kylemanna/teensy-toslink-receiver/teensy-toslink-receiver.kicad_pcb

## KiCad design teensy-toslink-receiver.kicad_pcb (2020-12-26)

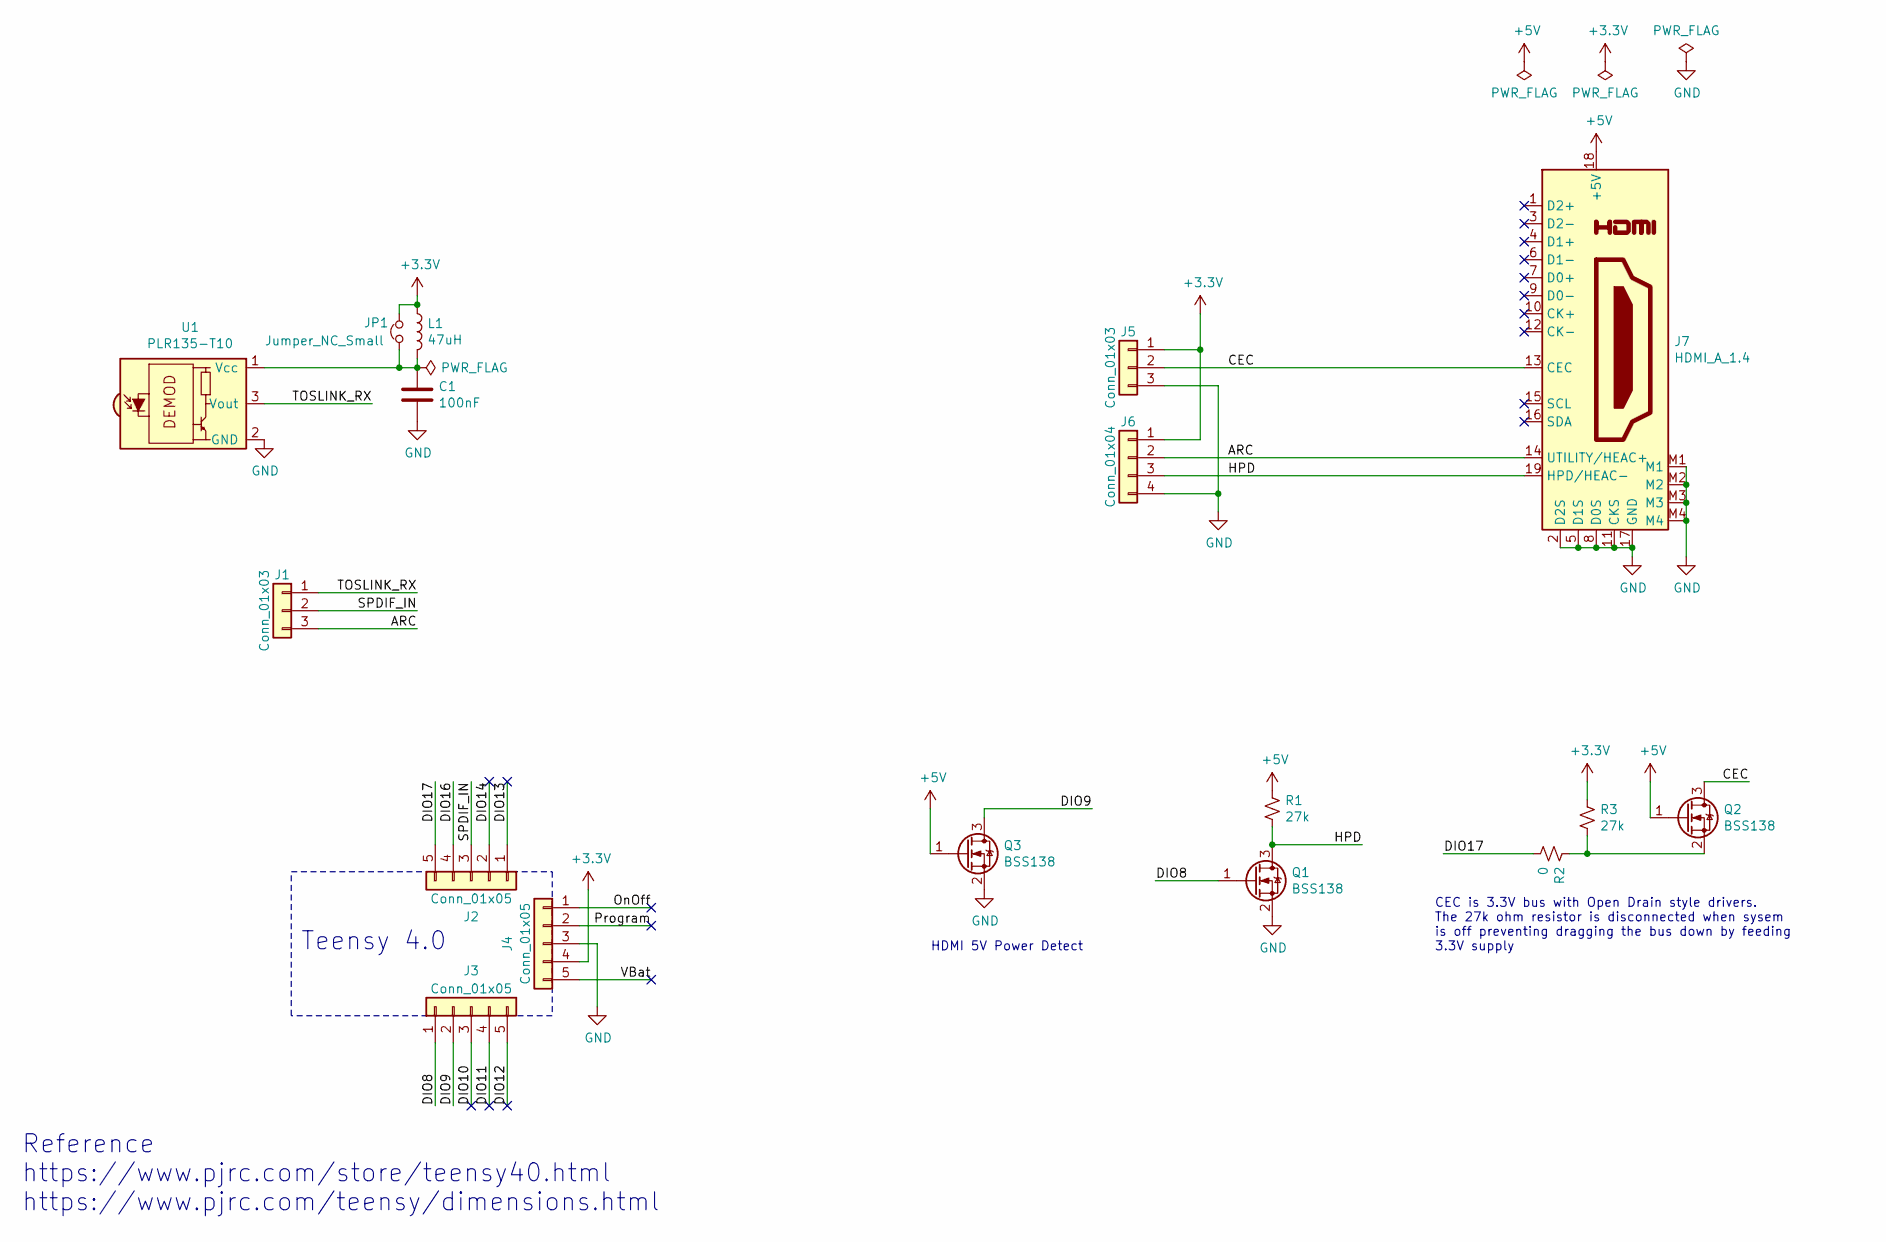
[picture p1: schematic teensy-toslink-receiver.sch]

Parts:
C1: 100nF; C_0603_1608Metric
J1, J5: Conn_01x03; PinHeader_1x03_P2.54mm_Vertical
J2, J3, J4: Conn_01x05; PinHeader_1x05_P2.54mm_Vertical
J6: Conn_01x04; PinHeader_1x04_P2.54mm_Vertical
J7: HDMI_A_1.4; Amphenol_ICC-10029449-001RLF-MFG
JP1: Jumper_NC_Small; SolderJumper-2_P1.3mm_Bridged_RoundedPad1.0x1.5mm
L1: 47uH; L_0805_2012Metric
Q1, Q2, Q3: BSS138; SOT-23
R1, R3: 27k; R_0201_0603Metric
R2: 0; R_0201_0603Metric
U1: PLR135-T10; Everlight_PLR135-T10

Connections:
+3V3: J4.4, J5.1, J6.1, JP1.2, L1.1, R3.2
+5V: J7.18 (+5V), Q2.1 (G), Q3.1 (G), R1.1
/ARC: J1.3, J6.2, J7.14 (UTILITY/HEAC+)
/CEC: J5.2, J7.13 (CEC), Q2.3 (D)
/DIO8: J3.1, Q1.1 (G)
/DIO9: J3.2, Q3.3 (D)
/DIO10: J3.3
/DIO11: J3.4
/DIO12: J3.5
/DIO13: J2.1
/DIO14: J2.2
/DIO16: J2.4
/DIO17: J2.5, R2.2
/HPD: J6.3, J7.19 (HPD/HEAC-), Q1.3 (D), R1.2
/OnOff: J4.1
/Program: J4.2
/SPDIF_IN: J1.2, J2.3
/TOSLINK_RX: J1.1, U1.3 (Vout)
/VBat: J4.5
GND: C1.2, J4.3, J5.3, J6.4, J7.2 (D2S), J7.5 (D1S), J7.8 (D0S), J7.11 (CKS), J7.17 (GND), J7.M1, J7.M2, J7.M3, J7.M4, Q1.2 (S), Q3.2 (S), U1.2 (GND)
unnamed: C1.1, JP1.1, L1.2, U1.1 (Vcc)
unnamed: Q2.2 (S), R2.1, R3.1

Notes on the sheet:
Reference https://www.pjrc.com/store/teensy40.html https://www.pjrc.com/teensy/dimensions.html
Teensy 4.0
CEC is 3.3V bus with Open Drain style drivers. The 27k ohm resistor is disconnected when sysem is off preventing dragging the bus down by feeding 3.3V supply
HDMI 5V Power Detect

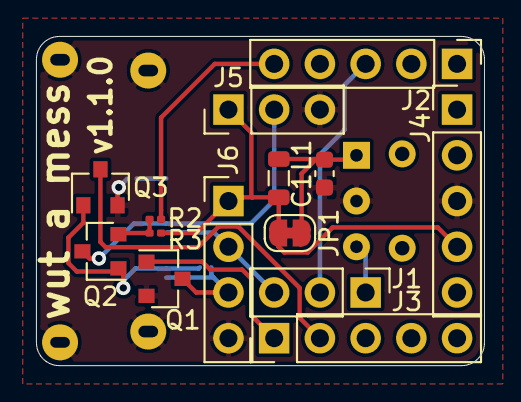
[picture p2: board teensy-toslink-receiver.kicad_pcb from above]

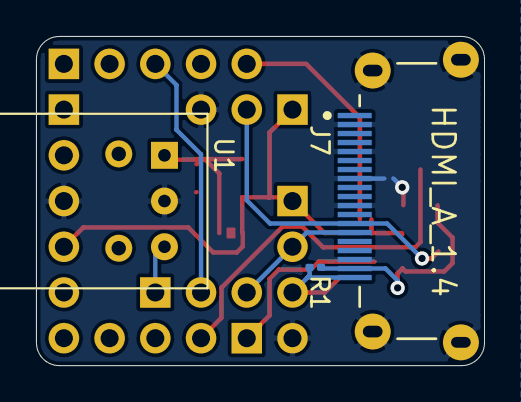
[picture p3: board teensy-toslink-receiver.kicad_pcb from below]

Board: 2 copper layers, 24.9 x 18.3 mm, 17 parts (3 on the bottom side), 13 nets.
