kylemanna/teensy-toslink-receiver/(commit log)

2020-11-16 repo: Inital commit
    [teensy-toslink-receiver.sch]
2020-11-16 pcb: Add first pass at PCB
    * I think this works.
    [teensy-toslink-receiver.kicad_pcb]
2020-11-16 gerbers: Add gerbers
    * Sent to OSHPark with zip timestamp 1605504464
    * $3.50 for 3x shipped.
    [teensy-toslink-receiver-B_Cu.gbr, teensy-toslink-receiver-B_Mask.gbr, teensy-toslink-receiver-B_SilkS.gbr, teensy-toslink-receiver-Edge_Cuts.gbr, teensy-toslink-receiver-F_Cu.gbr, teensy-toslink-receiver-F_Mask.gbr, teensy-toslink-receiver-F_SilkS.gbr, teensy-toslink-receiver.drl]
2020-11-28 pcb: Tighten up footprints
    * Tighten up the holes for footprints after fitting OSH Park PCB.
    [teensy-toslink-receiver.kicad_pcb]
2020-12-26 pcb: Fix incorrectly placed Teensy headers and move connectors to bottom
    * Headers were on inside when they should be on the outside. Oops.
    * HDMI and TOSLINK connectors moved to bottom to prevent blocking teensy
    reset button.
    [teensy-toslink-receiver.kicad_pcb]
2020-12-26 schematic: Add HPD and CEC FETs
    * N-Channel MOSFET to pull HPD low on connection.
    * N-Channel MOSFET acting as a diode to prevent dragging bus down.
    * N-Channel MOSFET to detect when HDMI cable is plugged in and 5V is
    available to start operation.
    [teensy-toslink-receiver.sch]
2020-12-26 pcb: Update PCB with new components
    * Tighten up tolerances with OSH Park rules for 0603 components.
    [teensy-toslink-receiver.kicad_pcb]
2020-12-26 gerbers: Update gerbers v1.1.0
    * Sent to OSHPark with zip timestamp 1608996768
    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
    [teensy-toslink-receiver-B_Cu.gbr, teensy-toslink-receiver-B_Mask.gbr, teensy-toslink-receiver-B_SilkS.gbr, teensy-toslink-receiver-Edge_Cuts.gbr, teensy-toslink-receiver-F_Cu.gbr, teensy-toslink-receiver-F_Mask.gbr, teensy-toslink-receiver-F_SilkS.gbr, teensy-toslink-receiver-NPTH.drl]
